Flopsstuff/keryx/firmware/README.md

# Firmware

ESP-IDF projects for the XIAO ESP32S3 on the reSpeaker Flex. The XVF3800 has to run the I2S firmware; see
[I2S mode](../docs/respeaker-flex-xvf3800.md#i2s-mode) in the board notes.

Flashing a release onto the board, with no ESP-IDF: [docs/flashing.md](../docs/flashing.md). Building, development
builds, console and releases: [docs/building.md](../docs/building.md).

## `xvf-bringup`

Checks that the ESP32, the XVF3800 and the codec work together:

1. scans I2C (expects 0x18 codec, 0x2C XVF3800) and reads the XVF3800 version and output routing;
2. measures BCLK, LRCLK and MCLK with the pins as inputs, and runs I2S as slave when the XVF3800 already drives
   them (it does with the I2S firmware), as master otherwise;
3. logs the level of both capture channels and the XVF3800 DoA twice a second, and plays a quiet 440 Hz beep
   (400 ms every 2 s, −24 dBFS) to the headphone jack. It holds the playback line low from the start and sends
   1.3 s of silence after I2S starts before the first beep; without that the first beep comes with noise.

## `mic-loopback`

Plays the XVF3800 capture straight back to the headphone jack from the ESP32, no host involved: processed beam in
the left ear, ASR beam in the right. 2 ms DMA blocks keep the ESP32's share of the delay at about 10 ms. Logs both
channel levels once a second.

## `usb-soundcard`

Prototype: the XIAO becomes a USB Audio Class device (`espressif/usb_device_uac` on TinyUSB), bridging the
XVF3800's I2S bus to the host.

- Microphone: 48 kHz, 16-bit stereo; left is the processed beam, right the ASR beam (the XVF3800's L/R outputs).
- At start-up it sets the XVF3800's ASR output gain (`AEC_ASROUTGAIN`, reset to 1.0 by the chip) to 4.0, +12 dB,
  over I2C with `components/xvf_control`. The ASR path has no AGC or limiter, so this fixed gain is its whole level
  control: speech at a distance now peaks around −15 dBFS instead of −27.
- Speaker: 48 kHz, 16-bit stereo, with the host's volume and mute applied in software, mixed to mono with everything
  else the board plays (see Volume below for how it reaches the codec and the XVF3800's echo reference).
- The start-up log is printed over the USB serial console; 4 s after boot TinyUSB takes the USB PHY, the console
  disappears and a composite device appears: the sound card (macOS lists it as "Keryx") and a CDC serial port
  (`/dev/cu.usbmodemkeryx_proto*` on macOS, `/dev/ttyACM*` on Linux, USB ID 303A:8000).
- That port is `components/keryx_console`: from then on the log goes there (while a host has the port open), and it
  takes commands, one per line: `bootloader` restarts into the ROM download mode on the serial/JTAG port, `reboot`
  restarts the firmware. `./flash.sh` uses `bootloader`, so no buttons are needed. Without it: press RESET while
  `./flash.sh` waits; holding BOOT on the XIAO while it powers up did not bring up the ROM download mode on our board.

## `wakeword`

The "Hey Keryx" wake word on the XIAO itself, from `components/keryx_wakeword`: the XVF3800's ASR channel goes
from 48 to 16 kHz with the filter the training audio went through (`scipy.signal.resample_poly`, run in esp-dsp's
decimating FIR, checked against plain C at start-up), into the
micro_speech frontend (`components/micro_frontend`, the TFLite Micro code pymicro-features wraps) and the model
from `wakeword/`, run streaming in float C: each 30 ms only the newest outputs of every layer are computed.

- A detection logs `>>> Hey Keryx! (score …)` and beeps on the headphone jack; the XVF3800 takes that line as its
  echo reference, so the beep does not reach the ASR channel.
- Once a second the log shows the highest score, the ASR peak level and the processing time per 10 ms of audio:
  about 0.86 ms (decimation 0.15, features 0.43, model 0.28), the model's weights kept in internal RAM.
- At start-up it sets `AEC_ASROUTGAIN` to 4.0, as `usb-soundcard` does: the model learned the channel at that gain.
- The model and threshold are `components/keryx_wakeword/kww_weights.h` and `include/kww_config.h`, written by
  `wakeword/export_model.py`.

The console stays on the USB serial port, so `idf.py monitor` (or `./flash.sh wakeword` and then any serial
terminal) shows the log. To record through the board again, flash `usb-soundcard`.

## `keryx`

The wake word and the USB sound card in one firmware; `wakeword` and `usb-soundcard` stay as their simpler
predecessors.

- One task reads I2S in 5 ms blocks and feeds both the wake word (ASR channel, as in `wakeword`) and the USB
  microphone (48 kHz, 16-bit stereo: processed beam, ASR beam) through a stream buffer. The XVF3800 clocks I2S and
  the host clocks USB, so audio older than 20 ms is dropped when the host reads.
- Playback: the host's packets go into a second buffer; a playback task writes I2S without a break, starting once
  30 ms are queued and dropping the excess beyond 80 ms. The sound card is asynchronous: its feedback endpoint asks
  the host for slightly more or fewer samples to keep ~40 ms queued, so the host follows the XVF3800's clock (the
  UAC component's own FIFO-count feedback lost ~0.4 % of the audio, see `components/usb_device_uac/KERYX.md`). A
  30 s sine plays without a single gap; the report shows the host's real rate.
- AEC: with clean playback the echo of speech from a speaker on the headphone jack reaches the ASR beam at the noise
  floor. The XVF3800's `AUDIO_MGR_SYS_DELAY` of −30 samples in this I2S build is right: 0, 12, 30 or 60 let the
  echo through.
- A detection prints `wake score=0.973` on the serial port (`components/keryx_console`, as in `usb-soundcard`) and
  plays a chime on the headphone jack, mixed into the host's playback. `sound thinking` loops a quiet "thinking"
  sound until `sound stop`, until the host's audio starts (above −54 dBFS) or for 60 s at most; `sound wake`
  plays the chime. The sounds are synthesised by `sounds/make_sounds.py` (`--export` writes the chosen ones to
  `keryx/main/keryx_sounds.h`; without it, candidates to listen to go to `sounds/candidates/`). The log goes to the same port, with a report every
  5 s: peak score, ASR level, processing time per 5 ms block (about 0.5 ms), USB microphone and speaker buffers.
- Serial port commands besides `bootloader` and `reboot`: `loop on` puts the XVF3800's echo reference — what was
  played — on the left capture channel instead of the processed beam, to measure the playback path; `loop mic`
  puts microphone 0 there, before AEC; `loop off` restores the beam. `xvf get|set <resid> <cmd> <int32|float|uint8>
  [count | values…]` reads or writes any XVF3800 parameter (e.g. `xvf get 33 3 int32`, AEC converged); `set` reads
  the value back, `xvf write …` does not, for write-only commands (the AEC filter's, see
  [the board notes](../docs/respeaker-flex-xvf3800.md#reading-the-aec-filter)). While
  `loop on` is set, the ASR beam lets echo through: it is for measuring only.
- Two I2C buses: the XVF3800's (D4/D5, also the codec) and one for our own STEMMA QT peripherals on D0 (SDA) / D3
  (SCL), I2C_NUM_1. They are kept apart because with the Adafruit rotary encoder (seesaw on a SAMD09) on the
  XVF3800's bus, the XVF3800 holds SCL for up to half a second after its address and stops answering — the ASR gain
  is then never set. `i2c scan` lists what answers on both, by bus (`xvf 0x2c XVF3800`, `periph 0x36 seesaw rotary
  encoder`; a held bus shows as `ESP_ERR_TIMEOUT`); `i2c read <addr> <n> [bytes…]` writes the bytes (a register),
  waits 5 ms and reads `n` bytes, `i2c write <addr> <bytes…>`, both on the peripherals' bus (e.g. `i2c read 0x36 4
  0x00 0x02`, a seesaw's product code and date), or with `xvf` on the XVF3800's (`i2c read xvf 0x18 1 82`, a codec
  register: there the read is one transaction with a repeated start, as the codec otherwise reads the next register).
- Pairing, through the same serial port (`components/keryx_net`): `set ssid|password|bridge|token <value>`,
  `config`, `erase`, `wifi scan`, `status`, `net check <host> <port>` (can the board open a TCP connection there:
  is the bridge reachable from this network?); answers end with an `ok` or `error` line. The settings live in NVS and
  survive flashing; the board joins Wi-Fi at start-up and after `set password`, retries with back-off (1 to 30 s),
  also when a connect fails at once (which sends no disconnect event), and reports `wifi associated ch=…`, `wifi
  connected ip=… rssi=…`, `wifi disconnected reason=…`, `wifi lost its address`. `status` also shows the XVF3800
  (`xvf=ok version=… i2s=running`, see Installing), the volume, the board's id (`keryx-` and the end of its MAC,
  also its USB serial number, so each board has its own port name), the firmware version (the last commit that
  touched `firmware/`, outside `release/`) and free memory. The XIAO needs its U.FL antenna: without it networks show at about −92 dBm.
- Memory: the wake word's weights and state take ~160 KB of internal RAM, and Wi-Fi needs its RX buffers there, so
  the 8 MB PSRAM is on for everything large, Wi-Fi, FreeRTOS and heap code stays in flash instead of IRAM, and Wi-Fi
  keeps 8 static RX buffers. About 33 KB of internal RAM stays free with Wi-Fi connected. The app builds for size
  except the wake word and its frontend (`-O2`); `partitions.csv` has two 3 MB app slots, for updates over Wi-Fi
  later, and 1.9 MB for a filesystem.
- What speech-to-text hears (`stt channel [l|r|a]`, kept in NVS, also over Wi-Fi): `l` (default) the processed beam,
  where the XVF3800's residual and non-linear echo suppression take Keryx's own voice out; `r` the ASR beam, as the wake
  word hears it, with no post-processing — inside the speaker Keryx's echo stays in it at about the user's level, and
  the beamformer turns to the speaker whenever the user pauses; `a` auto: L while the board plays and 1 s after (any
  output block above −54 dBFS), R otherwise, crossfading over 30 ms. L passes the XVF3800's AGC, so it is brought to R's
  level by ASR gain / AGC gain (`PP_AGCGAIN`, read every 0.5 s): the level does not jump between them. The wake word
  always runs on R. Both beams are decimated to 16 kHz, L's decimator in PSRAM. The firmware turns on `PP_NLATTENONOFF`
  (non-linear echo attenuation, off in Seeed's firmware) at start-up, as the XVF3800 forgets it at power-off; `status`
  shows `nl_atten=1`. Measured in the R1100 with the user silent while Keryx counted, then reading a sentence over it:
  Keryx's voice in L +6.1 dB over the room's noise without it, below the noise with it, at volume 54 and at 80, the
  first second included; the user's sentence over Keryx came through Whisper word for word either way, and R kept +7 to
  +11 dB of echo.
- The voice bridge (`components/keryx_link`): a WebSocket client to the `bridge` URL, connected all the time
  (ping every 10 s, reconnects every 2 s). Protocol v1 below. Wi-Fi power save (modem sleep, DTIM 3: pings take
  ~260 ms) goes off at a wake or a `play_start` (the bridge may speak first, with no wake) and back on 5 s after
  the stream and the playback have ended. The report adds a line for the link: state,
  frames up, bytes down, playback underruns.
- The watchdog (`main.c`): without the bridge for 3 min the board saves the end of its journal in NVS and restarts
  Wi-Fi (`keryx_net_restart`); after 10 min it saves it again and restarts, and if that brought no bridge either,
  restarts again every hour. Not while a USB host has the board (the bench, `converse.py`) or an update runs. With a
  saved journal the board's `hello` says `"saved_log":true`, and the bridge reads it (`log saved`) into its own log as
  `board saved log: …` lines, then clears it (`log saved clear`). A saved journal of an earlier run is kept until then,
  as that one saw the trouble begin. It began when a board stayed off Wi-Fi for eight hours, until it was powered off,
  with nothing left to say why.
- Volume: the board's own, 0–100 over everything it plays (the bridge's answers, its sounds, USB audio): 0 is silence,
  then 0.5 dB a step up to 0 dB at 100, kept in NVS (saved 2 s after the last change). It is the TLV320AIC3104 codec's
  analog volume in front of its output drivers (page 0, Table 10-51, soft-stepped by the codec): the DAC's hiss comes
  before it and goes down with the voice, where a software gain left it as loud at any volume. The XVF3800 takes its AEC
  reference from I2S channel 0 (L) only and sends both channels to the DACs, so the playback task puts different things
  in them: R is the mono mix at full scale, routed at the volume to the headphone jack (registers 50/64) and to the line
  output that feeds the amplifier on the SPEAKER connector (85); L is the same mix scaled in software by the codec's
  gain at that volume (Table 10-51's exact values), only the AEC reference, its routes to the outputs (47, 61, 82) off.
  The echo path from the reference to the microphones then does not change with the volume. With the volume after the
  reference it did, and the AEC, which follows a louder echo, never followed a quieter one: after the volume went down,
  Keryx's own voice stayed in the ASR beam at about −35 dBFS, at any lower volume and with the speaker muted, until the
  XVF3800 restarted; `AEC_FAR_EXTGAIN` (set to the volume, or its opposite) and rescaling the AEC filter by hand did not
  change that. Measured with the split, down from 66 or 90 to 40 the ASR beam carries Keryx at −54 to −58 dBFS, as a
  freshly converged AEC does. `AEC_FAR_EXTGAIN`, the gain between the reference and the loudspeaker, is therefore 0,
  written at start-up (the XVF3800 keeps it over a restart of the ESP32 alone); while the volume was a software gain,
  −23 dB at 54 made the residual echo suppression expect that much less echo, and Keryx's voice came through the
  processed beam at +20.6 dB over silence instead of +3.1 dB. Volume 0 also mutes the routes and the output drivers
  (registers 51/65/86, whose levels stay as the XVF3800 set them: +6 dB on the jack, 0 dB on the line; raising the
  line's only raised the hiss). The XVF3800 sets up the codec at boot (both DACs into every output), possibly after us,
  so the `xvf` task reads the registers back every 2 s and sets them again if they changed. `status` shows
  `far_extgain=…dB` and `codec=ok line=0x… line_from_l=0x… line_level=0x… reference=…dB` (registers 85, 82 and 86, and
  the reference's gain). At volume 90 the AEC cancels clearly less, in either scheme: probably the speaker is then
  louder than the microphones' gain allows for (see the board notes; not yet checked). `volume`, `volume <0-100>`,
  `volume up|down` (±10) on the console; `{"type":"volume",…}` from the bridge, see below. The macOS volume of the Keryx
  sound card still applies to USB audio on top, as a software gain.
- Microphone mute: while muted nothing captured leaves the board — the USB microphone and the bridge get silence,
  a running stream stops at once, the wake word does not run (and starts afresh, with its 2.5 s warm-up, when
  unmuted); playback is not affected. A short falling / rising two-note sound marks the change. Kept in NVS, saved
  0.2 s after a change. `mute`, `mute on|off` on the console (`wake` is refused while muted), `muted=0|1` in
  `status`; `{"type":"mute",…}` from the bridge, see below.
- `top [seconds]` on the console: how busy each core was and which tasks took the time. Idle, connected to Wi-Fi
  at 240 MHz: core 0 ~2 % (Wi-Fi, lwIP), core 1 ~12 % (the wake word 10 %, playback 2 %).
- More console commands: `wake` acts as if the wake word fired (to test the bridge without saying it), and
  `log <tag|*> <none|error|warn|info|debug>` changes a log level until the next restart (the WebSocket library's
  own log is off: it reports every failed attempt while the bridge is down).
- The journal (`components/keryx_console`): every line the console prints, except the 5 s report, also goes into 8 KB
  in PSRAM, each with the time it began (`HH:MM:SS` once SNTP has set the clock, `+<s since boot>s` before). `log
  recent` shows its last 2.7 KB, also over Wi-Fi; `log saved` the end the watchdog saved in NVS, `log saved clear`
  forgets it.
- Tasks: core 1 has capture (wake word, priority 6), playback (7) and the panel (3); core 0 USB, Wi-Fi, lwIP, the
  WebSocket client and the console. USB audio runs at priority 20, above lwIP (18): at 5 it starved during Wi-Fi
  traffic and dropped audio. The panel was on core 0 too, until an answer's audio, which the bridge sends faster than
  real time (10 s of it in about a second), kept Wi-Fi, lwIP and the WebSocket client busy long enough to stop the
  ring for over a second as Keryx began to speak. `status` counts the frames that came 150 ms or more late
  (`stalls=… longest=… ms`), and each one is logged with the panel's state.
- The panel (`components/keryx_panel`), on the peripherals' I2C bus: an Adafruit I2C QT Rotary Encoder (seesaw, 0x36)
  and an Adafruit NeoDriver (seesaw, 0x60) driving a ring of 24 WS2812. Turning the knob changes the volume, 2 steps (1
  dB) a detent, clockwise louder; a short press ends a running conversation (`{"type":"stop"}` to the bridge) and
  otherwise acts as the wake word; holding it for 1 s mutes or unmutes the microphone. The ring: a clock when idle
  (marks at 12, 3, 6 and 9, amber by day and yellow at night, the minute hand one blue pixel, the hour hand the two
  green pixels nearest its angle; the hands cover the marks, the minute hand the hour hand), the same clock with red
  marks when muted, a level meter while listening (the whole conversation) and while answering, a purple comet while
  waiting for the answer (the thinking sound), one orange pixel breathing without a bridge, and for 1.5 s after any
  volume change an arc as long as the volume. The meter: the pixels at 3 and 9 o'clock stay at half brightness, and arcs
  grow from them both ways, to meet at 12 and 6 at full level (quick up, slow down; brightest at the roots, over a faint
  glow of the rest). Listening it follows the ASR beam's peak, −45 to −12 dBFS, in blue (hue 220°), the glow breathing;
  answering it follows what is played before the volume (the answers, the board's sounds, USB audio), −40 to −8 dBFS, in
  turquoise (160°). `ring hue [<listening> <speaking>]` sets the two hues (0–359). Everything is drawn clockwise from 12
  o'clock: `ring top <0-23>` names the pixel at 12 and `ring reverse` flips the direction, as the ring is mounted. The
  brightness is at most a percentage of full, by day and by night: `ring brightness` shows it, `ring brightness
  day|night <1-100> [HH:MM]` sets a level and when it begins (default 20 % from 07:00, 5 % from 22:00). These settings
  live in NVS. The time comes over SNTP (`pool.ntp.org`), Europe/Warsaw (`CLOCK_TZ` in `main.c`); until then there is no
  clock and it is day. 30 frames a second; only frames that changed go out. Each module is looked for every 2 s until it
  answers, and again after an I2C error, so either can be missing or plugged in later. `status` adds `panel encoder=ok
  ring=ok i2c_errors=0`.
- The console over Wi-Fi: the bridge sends `{"type":"console","id":…,"line":…}`, the console task runs the line as if
  typed and sends back what it printed (`keryx_console_submit`, up to 3 KB). Only a safe set runs this way
  (`REMOTE_COMMANDS` in `main.c`: `status`, `config`, `volume`, `mute`, `wake`, `sound`, `ring`, `top`, `log`, `xvf
  get`, `i2c scan`, `i2c read`, `net check`, `ota`); `set`, `erase`, `wifi scan`, `bootloader`, `reboot`, `loop`, `xvf
  set` and `i2c write` need the serial port. On the bridge host: `./console.sh ring brightness`.
- Updates over Wi-Fi (`components/keryx_ota`): `ota`, `ota check`, `ota update [force]` (the latest GitHub release),
  `ota url <url>` (any image); a new image is on trial for 30 s and the bootloader rolls back one that restarts sooner.
  See [docs/building.md](../docs/building.md#updates-over-wi-fi).

### Bridge protocol v1

The board connects to `ws://…` (the `bridge` setting) and keeps the connection. Text frames are JSON; binary frames
are PCM16 little-endian mono.

| Direction | Message | Meaning |
|---|---|---|
| board → bridge | `{"type":"hello","id":…,"token":…,"firmware":…,"volume":…,"muted":…}` | first message; a wrong token: close with 4001. With `"saved_log":true` the board saved its journal while it had no bridge: the bridge reads it with the console line `log saved`, then `log saved clear` |
| bridge → board | `{"type":"ready"}` | accepted |
| board → bridge | `{"type":"wake","score":0.97,"preroll_ms":500}` | the wake word fired; audio follows |
| board → bridge | binary, 16 kHz, 20 ms (640 bytes) | the ASR beam: `preroll_ms` from before the wake, then live, until `listen_stop`. A wake during a stream sends `preroll_ms: 0` and the stream goes on unbroken |
| bridge → board | `{"type":"listen_stop"}` | stop streaming (the board stops by itself after 2 min) |
| bridge → board | `{"type":"sound","name":"wake"\|"thinking"\|"stop"}` | the board's own sounds |
| bridge → board | `{"type":"play_start","rate":24000}`, binary, `{"type":"play_end"}` | an answer, 24 or 16 kHz, any frame size, faster than real time is fine: the board buffers 10 s (holding back TCP beyond that), starts once 150 ms are queued and upsamples to 48 kHz |
| bridge → board | `{"type":"play_stop"}` | cut the answer now (10 ms fade) |
| board → bridge | `{"type":"played"}` | the answer has really finished playing, or was cut |
| bridge → board | `{"type":"volume","value":60}`, `{"type":"volume","delta":-10}`, `{"type":"volume"}` | set the volume, change it, or ask for it |
| board → bridge | `{"type":"volume","value":60}` | the volume, after every change whoever made it (bridge, console, the knob) |
| bridge → board | `{"type":"mute","value":true}`, `{"type":"mute"}` | mute or unmute the microphone, or ask whether it is muted |
| board → bridge | `{"type":"mute","value":true}` | the mute state, after every change whoever made it, and when asked; muting also ends a running stream at once |
| board → bridge | `{"type":"stop"}` | the stop button: end the conversation — the bridge stops the answer (`play_stop`) and the stream (`listen_stop`) |
| bridge → board | `{"type":"console","id":7,"line":"ring brightness"}` | run a console line, if it is in the safe set |
| board → bridge | `{"type":"console","id":7,"output":"ok ring brightness …\n"}` | what it printed (`error not allowed over Wi-Fi …` otherwise) |

Measured against a test server, through the echo reference (`loop on`): 24 and 16 kHz answers clean (residual
−40 dB), `played` 3.06 s after the first byte of a 3 s answer, 90–170 ms after `play_stop`; uplink frames 18 ms
apart on average, at most ~40 ms.
- The host should send 48 kHz: macOS converting 16 kHz on the fly (PortAudio with its default small blocks) breaks
  up the sound on this device; 24 and 44.1 kHz were fine.
