Flopsstuff/keryx/docs/respeaker-flex-xvf3800.md

# reSpeaker Flex XVF3800 Circular-4

The microphone array Keryx listens through: a Seeed Studio carrier board built around the XMOS XVF3800 voice
processor, with a 4-mic circular daughter board attached over FPC.

## Official documentation

Seeed Studio:

- [reSpeaker Flex wiki](https://wiki.seeedstudio.com/respeaker_flex_introduction/) — hardware, firmware
  variants, flashing, safe mode.
- [reSpeaker Flex repository](https://github.com/respeaker/reSpeaker_Flex) — firmware images
  (`xmos_firmwares/usb`, `xmos_firmwares/i2s`) and the Python control tool (`python_control/xvf_host.py`).
- [Product page, Circular-4](https://www.seeedstudio.com/reSpeaker-Flex-XVF3800-Circular-4-p-6737.html).
- [reSpeaker XVF3800 USB Mic Array wiki](https://wiki.seeedstudio.com/respeaker_xvf3800_introduction/) — the
  non-Flex sibling on the same chip; useful for overlapping topics.
- [reSpeaker XVF3800 USB 4-mic array repository](https://github.com/respeaker/reSpeaker_XVF3800_USB_4MIC_ARRAY)
  — native `xvf_host` binaries (including `mac_arm64`) and its
  [host control README](https://github.com/respeaker/reSpeaker_XVF3800_USB_4MIC_ARRAY/blob/master/host_control/README.md).

XMOS (the chip itself, firmware v3.2.1):

- [XVF3800 product page](https://www.xmos.com/xvf3800).
- [User Guide (HTML)](https://www.xmos.com/documentation/XM-014888-PC/html/doc/user_guide/index.html) /
  [PDF](https://www.xmos.com/documentation/XM-014888-PC/pdf/xvf3800_user_guide_v3.2.1.pdf) — control commands,
  output selection (section 3.6.1), tuning.
- [Using the host application](https://www.xmos.com/documentation/XM-014888-PC/html/modules/fwk_xvf/doc/user_guide/03_using_the_host_application.html).
- [Tuning the application](https://www.xmos.com/documentation/XM-014888-PC/html/modules/fwk_xvf/doc/user_guide/04_tuning_the_application.html).
- [Programming Guide (PDF)](https://www.xmos.com/documentation/XM-014888-PC/pdf/xvf3800_programming_guide_v3.2.1.pdf).

## Hardware

- 4 PDM MEMS microphones in a circle, 44 mm between neighbours, 360° pickup.
- XMOS XVF3800 does all DSP on-board: AEC, beamforming, DoA, AGC, VAD, noise suppression, de-reverberation.
- TLV320AIC3104 codec; 3.5 mm AUX out and a JST speaker connector driven by an amplifier (up to 10 W into 4 Ω,
  needs the 12 V terminal).
- USB-C (UAC 2.0 and DFU), 2 GPIO lines on the FPC, RST and Boot (safe mode) buttons.
- Footprint for an optional XIAO ESP32S3 connected over I2S + I2C; that setup needs the I2S firmware instead of
  the USB one.
- The green PWR LED sits on the power rail; no firmware can switch it off.

Core board, back and front

Images in this document come from the [Seeed wiki](https://wiki.seeedstudio.com/respeaker_flex_introduction/).

## Pins

Pin headers

### XVF3800 header (2×10)

Pin 1 is the square pad; 1–10 run down the outer column, 20–11 down the inner one.

XVF3800 header schematic

| Pin | Signal | Pin | Signal |
|---|---|---|---|
| 1 | X1D11 — I2S MCLK | 20 | X1D10 — I2S BCLK |
| 2 | X1D01 — I2S LRCK | 19 | X1D22 — I2S DATA1 (processed audio to the host) |
| 3 | X1D00 — I2S DATA0 (reference in from the host; out in USB builds) | 18 | X1D34 — I2S DATA2 |
| 4 | GND | 17 | GND |
| 5 | X0D38 — I2C SDA, 4.7 kΩ pull-up to VDDIO | 16 | X0D00 — SPI CS_N |
| 6 | X0D37 — I2C SCL, 4.7 kΩ pull-up to VDDIO | 15 | X0D10 — SPI CLK |
| 7 | X1D13 — button input (active low) | 14 | X0D11 — SPI MOSI |
| 8 | GND | 13 | X0D39 — SPI MISO |
| 9 | 5V_IN | 12 | GND |
| 10 | 5V_IN | 11 | VDDIO (3.3 V) |

The front silkscreen photo says X0D13 on pin 7; the schematic and the back silkscreen say X1D13.

### XIAO ESP32S3

XIAO schematic

The GPIO numbers printed inside the XIAO symbol above belong to a different XIAO; the ESP32-S3 numbers below come
from the XIAO ESP32S3 pinout.

| XIAO | ESP32-S3 | Used for |
|---|---|---|
| D0 | GPIO1 (ADC1, touch) | on the 4-pin header; SDA of our peripherals' I2C bus |
| D1 | GPIO2 | not on the header; most likely the XVF3800 reset line |
| D2 | GPIO3 (ADC1, touch, strapping pin) | free, on the 4-pin header |
| D3 | GPIO4 (ADC1, touch) | on the 4-pin header; SCL of our peripherals' I2C bus |
| D4 | GPIO5 | I2C SDA |
| D5 | GPIO6 | I2C SCL |
| D6 | GPIO43 | I2S DATA1, audio from the XVF3800 |
| D7 | GPIO44 | I2S DATA0, audio to the XVF3800 |
| D8 | GPIO7 | I2S LRCK |
| D9 | GPIO8 | I2S BCLK |
| D10 | GPIO9 | I2S MCLK |

The 4-pin header next to the XIAO carries GND, D3, D2 and D0; it has no 3.3 V pin.

### What is free for our own peripherals

- **ESP32 D2** (and D0, D3, which `keryx` uses for its peripherals' I2C bus) — any function through the GPIO matrix:
  buttons, an encoder (PCNT), WS2812 data (RMT). All three are ADC1 channels (GPIO1–10 are), so a resistor ladder can
  put several buttons on one pin; ADC1 keeps working while Wi-Fi is on. D2 (GPIO3) is a strapping pin: fine as a GPIO,
  but nothing should hold it at a fixed level during boot.
- **XVF3800 X0D11 and X0D39** — outputs driven with `GPO_WRITE_VALUE`, e.g. plain LEDs through a ~1 kΩ
  resistor. SPI control is not used by the USB or I2C builds. X0D00 and X0D10 cannot be driven from the Seeed
  firmware.
- **XVF3800 X1D13** — a button input; what the Seeed firmware does with it is unknown, and the Seeed
  `xvf_host.py` has no command to read it.
- **The shared I2C bus** (header pins 5 and 6, the same lines as XIAO D4/D5) — in principle room for I2C expanders,
  encoders or LED drivers, but the XVF3800 is a fussy slave here: with an Adafruit seesaw rotary encoder (SAMD09) on
  this bus it holds SCL after its address and stops answering, while a seesaw NeoDriver (ATtiny) was fine. The `keryx`
  firmware therefore puts its peripherals on a second bus on D0/D3, powered from VDDIO (pin 11). Taken addresses: 0x2C
  (XVF3800) and 0x18 (the TLV320AIC3104 codec). The XMOS pinout also lists this bus as the way the XVF3800 controls the
  DAC, so in the USB builds it probably acts as a master here; adding a second master needs care.
- **Power**: 5V_IN (pins 9, 10), VDDIO 3.3 V (pin 11), GND.

## Our unit

Since 2026-09-30 the board runs the I2S firmware `respeaker_flex_i2s_c48k2ch_v1.0.4.bin` and talks to the XIAO
ESP32S3 only; see [I2S mode](#i2s-mode). The readings below were taken over USB with the 6-channel USB firmware
on 2026-09-28:

| Property | Value |
|---|---|
| USB name | `reSpeaker Flex XVF3800 C16K6Ch` |
| VID / PID | `0x2886` / `0x001e` |
| Firmware | `VERSION` 1.0.3, `BLD_MSG` `ua-io16-6ch-sqr` (image `respeaker_flex_usb_c16k6ch_v1.0.3.bin`) |
| Audio | 6 channels in, 2 channels out, 16 kHz, 16-bit |
| `AEC_MIC_ARRAY_TYPE` | 2 (squarecular) |
| `AUDIO_MGR_MIC_GAIN` | 10.0 |
| `AUDIO_MGR_SYS_DELAY` | 12 samples |

Microphone positions from `AEC_MIC_ARRAY_GEO`, in metres:

| Mic | X | Y |
|---|---|---|
| 0 | 0.022 | -0.022 |
| 1 | 0.022 | 0.022 |
| 2 | -0.022 | 0.022 |
| 3 | -0.022 | -0.022 |

## Input channels of the 6-channel firmware

Each USB input channel is fed by an output mux configured as a `(category, source)` pair. The values below were
read from the device; the meaning comes from Table 3.2 of the XMOS User Guide.

| USB channel (0-based) | Command | Value | Signal |
|---|---|---|---|
| 0 | `AUDIO_MGR_OP_L` | 8, 0 | User chosen channel — currently a copy of the auto-select processed beam |
| 1 | `AUDIO_MGR_OP_R` | 7, 3 | ASR output of the auto-select beam |
| 2 | `AUDIO_MGR_OP_CH3` | 1, 0 | Raw mic 0, before amplification |
| 3 | `AUDIO_MGR_OP_CH4` | 1, 1 | Raw mic 1, before amplification |
| 4 | `AUDIO_MGR_OP_CH5` | 1, 2 | Raw mic 2, before amplification |
| 5 | `AUDIO_MGR_OP_CH6` | 1, 3 | Raw mic 3, before amplification |

Mux categories (XMOS User Guide, Table 3.2):

| Category | Signal | Sources |
|---|---|---|
| 0 | Silence | 0 |
| 1 | Raw microphone data, before amplification | 0–3: mic index |
| 2 | Unpacked microphone data | 0–3 (packed input only) |
| 3 | Amplified microphone data with system delay | 0–3: what the SHF cores receive |
| 4 | Far end (reference) | 0 |
| 5 | Far end (reference) with system delay | 0 |
| 6 | Processed data | 0, 1: slow-moving beams; 2: fast-moving beam; 3: auto-select beam |
| 7 | AEC residual / ASR data | 0–3: per mic residual or per beam ASR output |
| 8 | User chosen channels | 0, 1: copy of the auto-select beam by default |
| 9 | Post SHF DSP channels | 0–3 |
| 10 | Far end at native rate | 0–5 |
| 11 | Amplified microphone data before system delay | 0–3 |
| 12 | Amplified far end with system delay | 0 |

## I2S mode

Measured by `firmware/xvf-bringup` on the XIAO ESP32S3 with `respeaker_flex_i2s_c48k2ch_v1.0.4.bin`:

| Property | Value |
|---|---|
| I2C devices | 0x18 (TLV320AIC3104 codec), 0x2C (XVF3800) |
| `VERSION` | 1.0.4 |
| I2S clocks | **driven by the XVF3800**: BCLK 3.072 MHz, LRCLK 48 kHz, MCLK 24.576 MHz |
| I2S format | Philips, 32-bit slots, stereo; the ESP32 must run as I2S **slave** |
| Capture channels | L = `8,0` processed auto-select beam, R = `7,3` ASR auto-select beam |
| `AUDIO_MGR_OP_UPSAMPLE` / `AUDIO_MGR_OP_PACKED` | 1,1 / 0,0 |
| Playback | ESP32 → I2S DATA0 → codec → headphone jack works |
| Codec set-up by the XVF3800 | jack: DACs at 0 dB, drivers +6 dB; line out (LEFT_LOP/M): both DACs at −12 dB, 0 dB |
| Codec noise | the DAC hisses before its analog output volume: the hiss follows registers 82/85 and 86 |
| AEC reference | I2S channel 0 (L) only; both channels go to the DACs |
| `REBOOT` (48, 7) | restarts the XVF3800 in about 0.5 s, I2S included; parameters back to their defaults |
| Not answering over I2C | `BLD_MSG` (status 66), `AIC3104_HP_LEVEL` (status 97) |

The Seeed firmware README calls the I2S images "I2S slave" and the Seeed I2S test sketch runs the ESP32 as master,
but the bus is already clocked by the XVF3800 as soon as it boots; an ESP32 driving BCLK/LRCLK as well would fight
it.

Playback start-up: sound sent within the first moments after the ESP32 starts I2S comes out of the headphone jack
with noise. Sending silence for about a second first, and holding the ESP32's playback data pin (GPIO44) low from
the start of `app_main` until I2S takes it over, gives a clean first sound. Before `app_main` runs, during the ESP32
boot, that line still floats; a 10–100 kΩ pull-down on it would cover that window in hardware.

The I2C control protocol: write `{resid, cmd | 0x80, length + 1}`, then read `length + 1` bytes, the first being
a status (0 = OK, 64 = retry). Parameter ids are the same as over USB (see `xvf_host.py`).

### The AEC and the volume

Measured in the R1100 (its knob at half), with Keryx counting and nobody talking:

- The reference is I2S channel 0 only: noise in R alone comes out of the speaker and the microphones hear it, while
  the reference stays digital zero.
- The AEC follows a louder echo, not a quieter one. With a gain between the reference and the speaker turned down
  (the codec's volume, or the microphones' gain), the old echo stays subtracted: Keryx's voice stays in the ASR beam
  at about −35 dBFS, at any lower volume and even with the speaker muted, until the XVF3800 restarts or the gain
  comes back up. `AEC_FAR_EXTGAIN` does not change that, nor does path change detection (`AEC_PCD_COUPLINGI`, off
  by default), which only suppresses the processed beam harder, the user's voice included. `keryx` therefore keeps
  that gain constant: the volume is applied to the reference as well.
- Gain structure: at volume 100 the microphones after gain are 11–15 dB below the reference (XMOS asks for at least
  6 dB). The AEC filter's frequency-domain peak is −8.4 dB at volume 66, so above 0 dB near full volume, where XMOS
  says to lower `AUDIO_MGR_MIC_GAIN`; at volume 90 the AEC cancels clearly less.

### Reading the AEC filter

The AEC filter (3072 taps per microphone, `SPECIAL_CMD_AEC_FILTER_LENGTH` 33/93) can be read and written over I2C with
the special commands, in the order of XMOS' `host_xvf_control` (`src/special_commands/filters.cpp`):

1. `SHF_BYPASS` (33/70) = 1, so that the filter does not adapt meanwhile;
2. `SPECIAL_CMD_AEC_FAR_MIC_INDEX` (33/90) = far, mic — write-only: it must not be read back (`xvf write`, not
   `xvf set`). Read back, or sent without the bypass, it left the XVF3800's control dead until a power cycle;
3. for each chunk: `SPECIAL_CMD_AEC_FILTER_COEFF_START_OFFSET` (33/91) = offset, then read or write
   `SPECIAL_CMD_AEC_FILTER_COEFFS` (33/92), 15 floats — always 15, the last chunk padded;
4. `SHF_BYPASS` = 0.

Reads of one microphone after another work; a read after a write fails (status error) until
`AEC_FILTER_CMD_ABORT` (33/94) is written. Over the console a microphone takes about 22 s. Rescaling the filter
to a new volume gave the same filter as a fresh convergence at that volume, yet the echo stayed: the AEC keeps state
these commands do not reach.

### Switching firmware

- **USB → I2S:** with the USB firmware running, connect the Flex USB-C port (next to RST) and run
  `dfu-util -R -e -a 1 -D respeaker_flex_i2s_c48k2ch_v1.0.4.bin`. Afterwards the board disappears from USB.
- **I2S → USB:** power the board off, hold Boot, power it on (safe mode, USB DFU available), then flash a USB
  image the same way.
- Alt 1 is the upgrade partition; alt 0 holds the factory safe-mode image and is left alone.

## Control from macOS

`xvf_host.py` talks to the chip over USB control transfers and needs `pyusb` plus `libusb`
(`brew install libusb`). Without `--pid` it finds the device by the Seeed VID alone.

```bash
python xvf_host.py VERSION
python xvf_host.py --list              # every command with its description
python xvf_host.py DOA_VALUE           # angle 0..359 and a speech flag
python xvf_host.py AEC_AZIMUTH_VALUES  # radians: beam 1, beam 2, free-running, auto-select
python xvf_host.py AUDIO_MGR_OP_L 1 0  # route raw mic 0 to channel 0
python xvf_host.py SAVE_CONFIGURATION 1
```

Changes are lost on reboot unless saved with `SAVE_CONFIGURATION`; `CLEAR_CONFIGURATION` returns to defaults.
