Flopsstuff/keryx/(list of files, cad)

Other CAD files:
cad/bottle_cap.stl
cad/mic_hat.stl
cad/encoder_knob.stl
