Flopsstuff/keryx/firmware/components/xvf_control/include/xvf_control.h

/*
 * XVF3800 control over I2C: the same resource/command parameters as the USB control protocol (tools/xvf), see
 * docs/respeaker-flex-xvf3800.md for their meaning.
 */
#pragma once

#include <stddef.h>
#include <stdint.h>

#include "driver/gpio.h"
#include "driver/i2c_master.h"
#include "esp_err.h"

#define XVF_I2C_ADDR 0x2C

// AEC_ASROUTGAIN: fixed gain on the ASR output (float, linear, 0..1000, 1.0 after reset)
#define XVF_AEC_RESID 33
#define XVF_AEC_ASROUTGAIN 36
// AEC_FAR_EXTGAIN: gain in dB between the AEC reference and the loudspeaker (float, 0 by default): the volume, as
// it is the codec's, after the reference
#define XVF_AEC_FAR_EXTGAIN 5

// PP_AGCGAIN: the AGC's current gain on the processed beam (float, linear)
#define XVF_PP_RESID 17
#define XVF_PP_AGCGAIN 13
// PP_NLATTENONOFF: non-linear echo attenuation on the processed beam (int32, 0 off, 1 on; off in Seeed's firmware)
#define XVF_PP_NLATTENONOFF 27

esp_err_t xvf_control_init(gpio_num_t sda, gpio_num_t scl);

// The board's I2C bus (also the codec and our own peripherals), valid after xvf_control_init.
i2c_master_bus_handle_t xvf_i2c_bus(void);

// Write {resid, cmd | 0x80, length + 1}, then read back a status byte followed by the payload.
esp_err_t xvf_read(uint8_t resid, uint8_t cmd, void *out, size_t len);

// Write {resid, cmd, length, payload}. The chip does not acknowledge writes; read the value back to check.
esp_err_t xvf_write(uint8_t resid, uint8_t cmd, const void *data, size_t len);

// The TLV320AIC3104 codec on the same bus, which the XVF3800 sets up at boot (page 0 registers).
#define CODEC_I2C_ADDR 0x18
esp_err_t codec_read(uint8_t reg, uint8_t *value);
esp_err_t codec_write(uint8_t reg, uint8_t value);

// Writes a float parameter and reads it back; ESP_ERR_INVALID_RESPONSE if the chip reports something else.
esp_err_t xvf_set_float(uint8_t resid, uint8_t cmd, float value);

// Sets a float parameter from a background task, retrying until the chip reads it back: after power-up the
// XVF3800 boots more slowly than the ESP32 and does not answer at first. `name` is only for the log.
void xvf_set_float_when_ready(uint8_t resid, uint8_t cmd, float value, const char *name);
