Flopsstuff/keryx/(commit log)

2026-09-28 🎉 Start Keryx: README, .gitignore and .gitattributes
2026-09-28 ✨ Add XVF3800 control client and live dashboard
    tools/xvf reads and writes the chip's parameters over USB control
    transfers. tools/dashboard captures all six channels, polls the
    beamformer state and streams both to a browser page: beam directions
    and speech energy, a host-side SRP-PHAT scan over the raw mics, level
    meters, waveforms and spectrograms. The dial can be flipped and rotated
    to match how the board lies, and channels 2-5 can be re-routed between
    raw and amplified mic signals.
    [control.py]
2026-09-28 📝 Document reSpeaker Flex pin headers and free pins
    Adds the XVF3800 2x10 header and XIAO ESP32S3 pin maps from the Seeed
    wiki (board photos and header schematics under docs/images, stored in
    LFS), and lists what is free for our own peripherals: ESP32 D0/D2/D3,
    XVF3800 outputs X0D11/X0D39, the X1D13 button input and the shared I2C
    bus.
2026-09-30 ✨ Add XVF3800 I2S bring-up firmware for the XIAO ESP32S3
    firmware/xvf-bringup (ESP-IDF v5.5.5) checks the XIAO, XVF3800 and
    codec together: I2C scan and XVF3800 control reads, detection of who
    drives the I2S clocks, full-duplex I2S with level and DoA logging, and
    a beep to the headphone jack.
    The board notes gain an I2S mode section: with the Seeed I2S firmware
    the XVF3800 is the I2S clock master (48 kHz, 32-bit), so the ESP32 runs
    as slave; the I2C control protocol; how to switch between USB and I2S
    firmware; and how to get a clean first sound after I2S starts.
2026-09-30 ✨ Add USB sound card prototype on the XIAO ESP32S3
    firmware/usb-soundcard bridges the XVF3800's I2S bus to a USB Audio
    Class device: 48 kHz 16-bit stereo microphone (processed and ASR beams)
    and speaker to the headphone jack, with host volume and mute. macOS
    lists it as "Keryx".
    espressif/usb_device_uac 1.3.1 is vendored under firmware/components
    with one patch: the audio control interface string, which macOS shows
    as the device name, comes from CONFIG_UAC_TUSB_PRODUCT instead of the
    hard-coded "usb uac". firmware/flash.sh flashes within the few seconds
    the serial console exists after boot, since the XIAO's BOOT button did
    not bring up download mode here.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
2026-09-30 ✨ Add ESP32 microphone loopback firmware
    firmware/mic-loopback plays the XVF3800 capture straight back to the
    headphone jack from the ESP32, processed beam left and ASR beam right,
    with 2 ms DMA blocks for about 10 ms of delay on the ESP32 side.
2026-09-30 🔇 Silence ESP-IDF activation output in flash.sh
    export.sh reports its checks on stderr, which cluttered the script's
    output.
2026-10-03 ✨ Train the «Hey Keryx» wake word and run it on the ESP32
    The XIAO now recognises «Хей / Эй, Керикс» and "Hey, Keryx" by itself
    (6 of 6 live phrases on the first try) and beeps on the headphone jack.
    Firmware:
    - wakeword: the XVF3800's ASR channel goes to 16 kHz with the filter the
    training audio went through, into the micro_speech frontend and the model,
    streaming in float C; detections are logged and beeped.
    - components/keryx_wakeword: decimation, frontend wrapper, streaming model
    and its weights; components/micro_frontend: the TFLite Micro frontend and
    KISS FFT as pymicro-features builds them, vendored unchanged.
    - components/xvf_control: I2C control of the XVF3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
2026-10-03 ⚡️ Keep the wake word weights in RAM
    As const data the ~120 KB of weights stayed in flash behind the 32 KB data
    cache and streamed through it on every inference. In internal RAM the
    chain takes 1.1 ms per 10 ms of audio instead of 3.5 ms (decimation 0.41,
    features 0.44, model 0.29), which the firmware now logs separately.
2026-10-03 ⚡️ Decimate with esp-dsp's FIR
    The 48 -> 16 kHz filter runs in esp-dsp's decimating FIR, the ESP32-S3 SIMD
    build: 0.15 ms per 10 ms of audio instead of 0.41, 0.86 ms for the whole
    chain. esp-dsp needs 16-byte aligned buffers, so the filter falls back to the
    plain C version if it refuses them, and a start-up self-check compares the
    two (they differ by one 16-bit step at most).
2026-10-04 ✨ Add a serial console port next to the USB sound card
    usb-soundcard is now a composite device: the UAC sound card plus a CDC
    serial port (keryx_console) that carries the log and takes commands.
    `bootloader` restarts into the ROM download mode, which flash.sh uses,
    so flashing needs no buttons.
2026-10-04 ✨ Combine the wake word and the USB sound card in one firmware
    firmware/keryx reads I2S once and feeds the wake word and the USB
    microphone from it; detections go to the host as `wake score=…` on the
    serial console. Playback goes through its own buffer and a task that
    writes I2S without a break, which removes the gaps of writing each 1 ms
    USB packet straight to I2S. `loop on` routes the XVF3800's echo
    reference to the left capture channel to measure the playback path.
    tools/listen.py records the board around every wake event.
2026-10-04 🔊 Replace the wake beep with synthesised chime and thinking sounds
    firmware/sounds/make_sounds.py synthesises candidate interface sounds and
    exports the chosen ones (a rising glass ping for the wake word, soft
    falling taps for thinking) into keryx_sounds.h. The thinking loop runs on
    `sound thinking` until `sound stop`, the host's audio or 60 s.
    [main.c]
2026-10-04 ✨ Talk to Hermes through the board with converse.py
    tools/converse.py lets the Mac stand in for the voice bridge: the board's
    wake word opens one xAI streaming speech-to-text session (Smart Turn) for
    the whole conversation, each utterance goes to Hermes'
    /v1/chat/completions, and every finished sentence of the streamed reply
    goes to xAI text-to-speech and plays through the board, so the XVF3800
    cancels it as echo. Follow-up requests need no wake word; talking over an
    answer stops it; words heard while the speaker played that Keryx itself
    said are dropped as echo. The board's mic and speaker share one duplex
    stream, since CoreAudio refuses a second one on the same device, and the
    board play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
2026-10-04 ✨ Pair the board over the USB console and join Wi-Fi
    components/keryx_net keeps Wi-Fi and voice bridge settings in NVS, set
    through new console commands (set, config, erase, wifi scan, status,
    net check), joins Wi-Fi at start-up and reconnects with back-off. Each
    board gets a USB serial number from its MAC.
    To make room for Wi-Fi, PSRAM is on, Wi-Fi/FreeRTOS/heap code moves from
    IRAM to flash and Wi-Fi keeps 8 static RX buffers; the app builds for
    size except the wake word. A custom partition table has two 3 MB app
    slots and a filesystem.
    [partitions.csv]
2026-10-04 💬 Rewrite the voice prompt in English with a device status section
    The prompt now says what Keryx is, how to answer for speech (short,
    plain spoken text, a quick first sentence, Russian by default), and that
    a "Device status" section follows for the bridge to fill with the
    speaker's state.
2026-10-04 ✨ Add bridge.py: the voice bridge for the board on Wi-Fi
    The pipeline of converse.py moves to tools/voice.py and works through
    three adapters: a microphone, a speaker and the board's sound commands.
    converse.py keeps the USB ones (sound card, serial console); bridge.py
    adds a WebSocket server on :8765/keryx speaking protocol v1 agreed with
    the firmware: hello with a token (KERYX_BRIDGE_TOKEN in .env), wake plus
    16 kHz microphone frames up, play_start / PCM / play_end, play_stop,
    sound and listen_stop down, played when the board has finished. Tested
    with a fake board client; --echo answers without Hermes.
2026-10-04 ✨ Talk to the voice bridge over a WebSocket
    components/keryx_link keeps a WebSocket to the bridge and speaks protocol
    v1 (firmware/README.md): after a wake it streams the 16 kHz ASR beam with
    500 ms of preroll until listen_stop, plays the bridge's 24 or 16 kHz
    answers through a 10 s buffer and an upsampler, cuts them on play_stop
    and reports played. Wi-Fi power save is off during a conversation.
    Internal RAM ran out with the client: its buffers and the link task's
    stack go to PSRAM. USB audio tasks run at priority 20, above lwIP, which
    is pinned to core 0: Wi-Fi traffic starved them. New console commands:
    wake, to test without saying it, and log, to change log levels.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
2026-10-04 🐛 Stop the USB speaker from losing audio, and steer the host's rate
    The UAC component read exactly 1 ms per packet into a single buffer: a
    packet the speaker task had not taken was overwritten (~0.4 % of the
    audio lost, clicks the AEC could not cancel). The task now takes all
    the FIFO holds, and the feedback endpoint follows the fill of our own
    playback buffer instead of the FIFO count, so the host follows the
    XVF3800's clock: a 30 s sine plays without a gap.
    Console: xvf get|set for any XVF3800 parameter, loop mic for the echo
    before AEC.
2026-10-04 🔊 Give the board a volume the bridge and the console can set
    One volume, 0-100, over everything the board plays: the bridge's
    answers, its own sounds and USB audio. It is kept in NVS, set with
    `volume` on the console and with {"type":"volume"} from the bridge,
    and reported back to the bridge after every change and in hello, so
    Hermes can read and change it.
    Console: `top` shows how busy each core and task is.
2026-10-04 🔧 Version the firmware by firmware/ alone
    ESP-IDF's version marks the build dirty for any uncommitted change in
    the repository, host tools included. Take the last commit that touched
    firmware/ instead, and "-dirty" only for changes under it.
2026-10-04 📦 Make the voice bridge an installable package with a service
    tools/voice.py and tools/bridge.py move to bridge/keryx_bridge/ and the
    voice prompt into the package, so the bridge installs on its own from a
    checkout: bridge/install.sh makes a venv, installs the keryx-bridge
    command, creates ~/.config/keryx/bridge.env with a fresh board token and
    the systemd user service. keryx-bridge runs the bridge, checks the
    settings against Hermes and xAI, pairs a board on USB (Wi-Fi, this
    machine's address, the token) and shows status or sets the volume
    through the bridge's HTTP control, which also feeds the board's volume
    into the prompt's device status section.
    The bridge now sends text.done after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
2026-10-04 📦 Release images and a flash script that needs no ESP-IDF
    firmware/release.sh builds firmware/keryx from a committed tree into
    firmware/release/: the parts with their addresses (not a merged image,
    which would wipe the pairing in NVS), VERSION and an ESP Web Tools
    manifest. firmware/flash_release.py flashes them with just esptool: it
    finds the board by USB ID, sends `bootloader` to Keryx firmware and
    checks that the board comes back with the new version.
    `status` now tells whether the XVF3800 answers, its firmware version
    and whether it clocks I2S (only its I2S firmware does); README says how
    to put it on that firmware. The version ignores firmware/release/.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
2026-10-04 📦 Release 0d29ff5
2026-10-04 ✨ Set up Keryx with one script
    setup.sh, run on the machine that will host the bridge with the board on
    USB, installs the bridge and its service (asking for the xAI and Hermes
    keys when the config lacks them), flashes the release with
    firmware/flash_release.py and pairs the board. --no-flash, --no-service
    and --port cover the other cases; bridge/README.md now starts with it and
    also explains pairing from another computer.
2026-10-04 💬 Tell Hermes where the bridge lives
    The device status lines appended to the voice prompt now also say where
    the bridge's checkout and config are, how its service is run and logged,
    and the keryx-bridge command for the volume, so Hermes on the same
    machine can change the volume or look into the bridge's code when asked.
2026-10-04 🔊 Add set_volume.sh for Hermes to call
    ./set_volume.sh 60, +10 or -10 sets the board's volume through the bridge
    running on this machine and prints the volume the board reports; with
    no argument it prints the current one. The device status lines now point
    Hermes at it instead of the keryx-bridge command.
2026-10-04 📝 Point the bridge at docs/flashing.md and drop a real board id
    The protocol example used the id of an actual board, part of its MAC;
    it is a made-up one now. Links and the XVF3800 hint in `pair` go to the
    new docs/flashing.md.
2026-10-04 🗣️ Let Hermes speak on its own with say.sh
    ./say.sh "text" (or keryx-bridge say, or POST /keryx/say) synthesizes the
    text with xAI on a socket of its own and plays it on the board once any
    answer in progress is over, returning when the board has played it. In a
    conversation the words also feed the echo filter, and the text goes into
    the voice history. The device status lines point Hermes at say.sh, for
    reminders, timers and anything the user asked to be told later.
2026-10-04 ⚡️ Keep Wi-Fi awake while the bridge plays on its own
    The bridge can now speak first (Hermes' say), with no wake before it.
    Power save went off only at a wake, so such an answer came over modem
    sleep. It now also goes off while an answer plays, and back on 5 s
    after.
2026-10-04 📦 Release 61072ba
2026-10-04 🐛 Stop Keryx from interrupting itself on its misheard echo
    With the board's speaker, speech-to-text keeps hearing Keryx and mishears
    its words (узнаю as знаю, имя as имени), which the echo filter's
    five-letter match missed: the answer stopped as if the user had spoken,
    and the fragment went to Hermes as a request. Words now count as echo
    when they are close to any word Keryx said, and words of one or two
    letters during playback do not count for the user. An answer stops only
    for at least two of the user's words, no fewer than the echo's, or a
    stop word; a final utterance of up to three words drowned in twice as
    much echo is dropped.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
    [voice.py]
2026-10-04 📝 Describe Keryx in the README, with a photo of the prototype
    The README now says what Keryx does and how (wake word on the board, the
    bridge, Hermes, xAI speech), what it needs, the one-command setup and
    where the documentation starts (docs/index.md). The photo's Seeed label
    with its QR code and serial number is pixelated.
2026-10-04 📝 Link the XIAO ESP32S3 and the reSpeaker Flex in the README
2026-10-04 🔇 Mute the microphone from the bridge
    ./mute.sh [30m] and ./unmute.sh (keryx-bridge mute|unmute, POST
    /keryx/mute) send the new protocol message {"type":"mute","value":…};
    the board, not the bridge, stops waking and streaming, and keeps the
    state across restarts (firmware side to follow). A timed mute is the
    bridge's timer. The board's state comes with hello and every change,
    shows in keryx-bridge status and in the device status lines, so Hermes
    can mute when asked not to listen; muting ends a conversation in
    progress. Only the microphone: the board still speaks.
2026-10-04 🔇 Mute the microphone on request
    While muted nothing captured leaves the board: the USB microphone and
    the bridge get silence, a running stream stops at once and the wake
    word does not run; playback goes on. The state is kept in NVS (read
    before capture starts), marked by a falling or rising two-note sound,
    set with `mute on|off` on the console and {"type":"mute"} from the
    bridge, and reported back after every change and in hello.
2026-10-04 📦 Release a71fb59
2026-10-04 📄 License Keryx under Apache 2.0
    The README lists the vendored components' own licenses and where the
    board images come from; the bridge package declares the license too.
2026-10-04 📝 Show the architecture as a picture in the README
2026-10-04 📝 Drop the image credit line from the README license section
2026-10-04 ✨ Keep the voice conversation in a Hermes session
    Each request carries only the new utterance with X-Hermes-Session-Id and
    X-Hermes-Session-Key: keryx; Hermes keeps the history. A wake word within
    KERYX_SESSION_TIMEOUT (1h) of the last exchange continues the session, which
    survives restarts. Interruptions and say.sh reach Hermes as bracketed notes.
    KERYX_FOLLOW_UP sets the follow-up window, now 7 s.
2026-10-04 🐛 Close the board's playback when an answer fails
    When Hermes or TTS raised mid-answer, the error path only cancelled the
    receiver: the board got neither play_stop nor play_end, so it kept its
    playback open (Wi-Fi awake, say.sh waiting on it), and audio still being
    synthesized on the shared TTS socket could leak into the next answer. The
    error path now shares the interruption's cleanup (Assistant.abandon):
    speaker.clear() and a fresh TTS socket.
    Checked with a mocked Hermes failing after the first sentence: before,
    speaker.clear() 0 calls and the TTS socket left open; after, 1 call, the
    socket closed and reopened.
    [voice.py]
2026-10-04 🐛 Decide the Hermes session at the wake word, not per request
    The session timeout was checked before every request, so with a timeout
    shorter than a conversation (0 in particular, documented as a new session
    per wake word) every follow-up went to a fresh session and Hermes lost the
    exchange just before it. The bridge now decides when a conversation begins
    (and in say.sh when none is running) and keeps that session for all its
    exchanges.
    Checked with a mocked Hermes, one wake word with two exchanges and then a
    second wake word: with --session-timeout 0, before 3 different sessions,
    after the same one twice and a new one for the second wake word; with 1h,
    one session throughout.
    Co-Author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
    [voice.py]
2026-10-04 🐛 Finish a timed mute that runs out while the board is away
    unmute_after cleared the timer and muted_until before sending the unmute,
    so when the board was disconnected at that moment set_mute returned None,
    nothing was left to retry, and the board came back still muted: a timed
    mute became a permanent one. A failed unmute now keeps muted_until, and
    when the board connects again resume_timed_mute lifts a mute that ran out
    meanwhile (or re-arms the timer for one still running).
    Checked with a stand-in board link offline when the mute ends and online
    afterwards: before, one failed unmute and the board stays muted; after,
    the unmute is sent again on reconnect and the board is unmuted.
    Co-A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
    [server.py]
2026-10-04 🐛 End the wake and sound console commands with ok
    `sound wake|thinking|stop` printed nothing and `wake` only its
    `wake score=…` event line, while every console answer is meant to end
    with an ok or error line: a client waiting for it, like keryx-bridge's
    board console (which skips `wake …` lines as events), sat until its
    timeout although the command had worked. They now end with `ok …`.
    Checked that firmware/keryx builds (idf.py into a separate build
    directory); not flashed or run on the board.
    [main.c]
2026-10-04 📦 Release 8398e85
2026-10-04 🔊 Let Hermes use xAI's speech tags
    The voice prompt lists the tags xAI text-to-speech performs ([laugh],
    [pause], <whisper>…</whisper>, <singing>…</singing> and the rest) and when
    to use them. The bridge keeps them intact: speakable() no longer strips
    the > of a wrapping tag, an answer is not cut into TTS chunks inside a
    wrapping tag, and the echo filter and the notes to Hermes see the text
    without tags.
    Checked against xAI: the same phrase is 25% longer in <slow>, 16% shorter
    in <fast>, 4.4 dB quieter in <whisper>, 2 s longer with [long-pause];
    all 21 tags played on the board through say.sh.
    [server.py, voice.py]
2026-10-04 📝 Link xAI's list of voices
2026-10-06 ✨ Put our I2C peripherals on a bus of their own
    With the Adafruit rotary encoder (seesaw on a SAMD09) on the XVF3800's bus, the XVF3800 holds SCL for up to half
    a second after its address and stops answering, so the ASR gain is never set. The STEMMA QT peripherals now get
    I2C_NUM_1 on D0/D3. Console: `i2c scan` lists both buses, `i2c read|write` talk to the peripherals' one.
2026-10-06 ✨ Add the knob and LED ring panel, a clock, and the console over Wi-Fi
    - keryx_panel: the Adafruit seesaw rotary encoder (volume, a short press to stop or wake, a long one to mute) and
    the NeoDriver ring of 24 WS2812 showing listening / thinking / speaking / muted, the volume after a change, and a
    clock when idle (amber marks, blue minute hand, two green pixels for the hour; red marks when muted). Modules may
    be missing or plugged in later.
    - ring top|reverse and ring brightness day|night <1-100> [HH:MM] on the console, kept in NVS; time over SNTP.
    - Protocol v1 gains {"type":"stop"} (the stop button ends the conversation) and {"type":"console"}: the bridge's
    POST /keryx/console, k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
    [cli.py, keryx_panel.c, keryx_panel.h, main.c]
2026-10-06 📦 Release 60b381d
2026-10-06 ✨ Update the firmware over Wi-Fi, from GitHub releases or any URL
    - keryx_ota: `ota`, `ota check`, `ota update [force]` (the latest GitHub release) and `ota url <url>`, on the console
    and over Wi-Fi; the download writes the other app slot and restarts into it, the ring shows the progress.
    - The bootloader rolls back a new image that restarts within 30 s (CONFIG_BOOTLOADER_APP_ROLLBACK_ENABLE); after
    that the app keeps itself. A board needs one USB flash with this bootloader.
    - firmware/publish.sh makes firmware/release/ the latest GitHub release; tools/ota_push.py flashes a local build
    over Wi-Fi through the bridge's console or USB.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
2026-10-06 📦 Release 17c2b76
2026-10-06 🐛 Fit GitHub's signed redirect into the OTA request buffer
    `ota check` failed with ESP_ERR_HTTP_WRITE_DATA once a release existed: the request to the release asset's signed
    URL did not fit into 1 KB.
2026-10-06 📦 Release a0d4b91
2026-10-06 🔧 Add watch_board.sh: USB, ping and bridge, once a second
2026-10-06 💄 Clock marks amber by day, yellow at night
    By day the yellow marks looked green: amber (R 12 G 6 at 10 %). At a night's 2 % the eye takes R 2 G 1 for red, the
    same as the marks of mute: yellow there (R 2 G 2).
2026-10-06 📦 Release 975d330
2026-10-06 🥅 Show how the last update went in `ota`
    An update's lines went to the serial port only, so over Wi-Fi a failed `ota update` left no trace; `ota` now shows
    the last result.
2026-10-06 ✨ Let say speak at a volume of its own, for Hermes at night
    say.sh --volume N, keryx-bridge say --volume N and POST /keryx/say {"volume": N}: below the board's volume the
    bridge turns the speech down itself, so the board's volume and ring stay as they are; above it the board's volume
    goes up for the phrase and back. Hermes is told to use a low one at night or when asked to be quiet.
2026-10-06 ✨ Let say take a volume relative to the board's
    say.sh --volume -20 / +10 and POST /keryx/say {"volume_delta": n}, as set_volume.sh takes +n / -n.
2026-10-06 📦 Release 6586909
2026-10-06 📝 Add the assembly in an Edifier R1100, with photos
2026-10-06 📝 Draw the wiring of the R1100 build
    Power from the speaker's 17 V through two step-downs (12 V for the Flex, 5 V for the ring), the STEMMA QT bus from
    the Flex's pins through the encoder to the NeoDriver, and SPEAKER through the isolation transformer into AUX R.
2026-10-06 📝 Show the R1100 build in the README, front and back
2026-10-10 ✨ Choose what speech-to-text hears: processed, ASR or auto
    Inside the speaker the ASR beam (R) carries Keryx's own voice at about the user's level, and STT took it for the
    user: the answers interrupted themselves. `stt channel l|r|a` (NVS, also over Wi-Fi): l, the default, sends the
    processed beam, where the XVF3800's residual echo suppression removes it; r the ASR beam as before; a crossfades
    (30 ms) to L while the board plays and back to R a second after. L is brought to R's level by ASR gain / AGC gain,
    read every 0.5 s. The wake word stays on R.
2026-10-10 🐛 Keep AEC_FAR_EXTGAIN at 0: our volume comes before the reference
    AEC_FAR_EXTGAIN is the gain between the AEC reference and the loudspeaker, as in the XVF3800's USB variant, which
    applies the host's volume there. Our volume is applied before the reference, so following it (401a6d1) told the
    residual echo suppression to expect 23 dB less echo at volume 54: measured on the board, Keryx's voice came through
    the processed beam at +20.6 dB over silence and Whisper read it word for word; at 0 dB it is +3.1 dB and nothing is
    heard. The firmware writes 0 at start-up, as the XVF3800 keeps it across a restart of the ESP32 alone.
2026-10-10 🔊 Turn on the XVF3800's non-linear echo attenuation at start-up
    PP_NLATTENONOFF, the last stage of the processed beam's echo suppression, is off in Seeed's firmware. In the R1100,
    with the user silent while Keryx counted: Keryx's voice in L at +6.1 dB over the room's noise without it, below the
    noise with it, at volume 54 and at 80, the first second included; the user reading a sentence over Keryx came
    through Whisper word for word either way. Written at start-up with AEC_FAR_EXTGAIN, as the XVF3800 forgets it at
    power-off; `status` shows `nl_atten`.
    [main.c, xvf_control.h]
2026-10-10 📦 Release 3dbc389
2026-10-10 🐛 Use software AES, so updates from GitHub fit into internal RAM
    `ota check` and `ota update` failed with "esp-aes: Failed to allocate memory": the hardware AES goes through DMA,
    which reads internal RAM only, and for TLS buffers in PSRAM it asks for a bounce buffer there, which the update
    task's 8 KB stack had left no room for. The software one works in PSRAM; TLS is only used for updates.
2026-10-10 📦 Release 24824f1
2026-10-10 🔊 Make the volume the codec's analog volume, so the DAC's hiss goes down with it
    The DAC hisses: with the volume a software gain before it, the hiss stayed as loud at any volume. The volume now sets
    the TLV320AIC3104's analog volume in front of its output drivers (0.5 dB a step, soft-stepped; listened to, the hiss
    follows it): registers 47/64 for the jack at 100 - v steps, 82/85 for the line output to the amplifier 12 steps lower,
    as it mixes both DACs; 0 also mutes the routes and the drivers. The drivers' levels stay as the XVF3800 set them
    (raising the line's only raised the hiss). The XVF3800 sets the codec up at boot, so the registers are read back every
    2 s and set again. As the volu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
2026-10-10 📦 Release 501c502
2026-10-10 🐛 Give the console a 6 KB stack: `status` overflowed 4 KB
    With the codec's line added, `status` overflowed the console task's 4 KB stack and the board restarted (reliably over
    Wi-Fi about a minute after boot, every time once a 320-byte buffer was added to it). The console's stack stays in
    internal RAM, as commands write NVS. `status` now shows the codec registers as the xvf task last read them, so only
    that task talks to the codec.
2026-10-10 📦 Release e48fe65
2026-10-10 ✨ Add the printed parts: mic hat and encoder knob as Onshape features
    Each part is a parametric Onshape custom feature written in FeatureScript (cad/*.fs) with the STL it was printed
    from. The mic hat covers the microphone array with slots over each mic, a post for double-sided tape and an
    engraved label; the encoder knob has a nut skirt, one support-free cone to a bore with crush ribs. The bottle cap is
    the test piece the workflow started with. STL, 3MF and STEP go through Git LFS; .mcp.json connects Onshape's
    FeatureScript MCP server; cad/README.md describes the parts and how to edit them.
    [bottle_cap.stl, encoder_knob.stl, mic_hat.stl]
2026-10-11 🖼️ Add the herald title image as a docs asset (#1)
    Key art of Keryx the herald proclaiming from the temple steps, with the speaker grille set into the marble. Unreferenced on purpose: an asset for the project catalogue and other presentation surfaces, not part of any document here.
2026-10-11 🔍 Capture diagnostics for voice interruptions
2026-10-11 📸 Show the printed mic hat: assembly photos and a new front photo in the README
2026-10-11 🔊 Keep the echo path fixed: play on R, put the volume on the AEC reference in L
    With the volume on the codec after the AEC reference, turning it down broke echo cancellation: the AEC follows a
    louder echo but never a quieter one, so after the volume went down Keryx's own voice stayed in the ASR beam at about
    -35 dBFS, at any lower volume and even with the speaker muted, until the XVF3800 restarted. AEC_FAR_EXTGAIN (set to
    the volume or its opposite), path change detection and rescaling the AEC filter by hand did not help.
    The XVF3800 takes its reference from I2S channel L only and sends both channels to the DACs. The playback task now
    puts the mono mix at full scale in R, routed at the c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
2026-10-11 ✨ Show listening and speaking as level meters from 3 and 9 o'clock
    The whole ring used to light as one: blue breathing while listening, deaf to the voice, and green pulsing with the
    answer. Now both draw a meter: the pixels at 3 and 9 o'clock stay at half brightness, and arcs grow from them both
    ways to meet at 12 and 6 at full level, brightest at their roots, quick up and slow down, over a faint glow.
    Listening follows the ASR beam's peak (-45 to -12 dBFS), answering what is played before the volume (-40 to -8 dBFS:
    the answers, the board's sounds and USB audio alike). The colours move apart a little, around blue: 220 for listening,
    160 for speaking, set with `ring hue` and kept in NVS.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
2026-10-11 📦 Release 3a6ee0c
2026-10-11 🎥 Add a demo video and link it from the README
2026-10-11 🎥 Play the demo video inline in the README
2026-10-11 🖼️ Put the front, back and demo video side by side in the README
2026-10-11 📝 Link the assembly page under the README's photos
2026-10-11 📝 Shorten the README's photo captions to Front, Back and Demo
2026-10-18 ✨ Tag every request with who is talking: voice ID
    The bridge now tells Hermes who is speaking: each request goes with a tag in
    front, [voice: Name 0.97], the most likely of the household's speakers (or
    unknown, or two names for two people in one utterance) and how sure that is.
    keryx_bridge/voiceid.py takes the audio of an utterance's non-echo words from
    the board's stream, embeds it with ERes2NetV2 and CAM++ (sherpa-onnx, the new
    voiceid extra), scores it against the voice profiles and calibrates it; the
    belief carries over a conversation with a stay probability that falls with the
    pause. It runs in a thread and the request waits for it at most 2 s.
    voiceid/ makes the bundle the bridge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
2026-10-18 ⚡️ Embed the slow model on an utterance's first 2 s, the models side by side
    On the Raspberry Pi 5 ERes2NetV2 takes about 0.23 s per second of audio, so a
    6 s request waited 2 s for its voice tag before it went to Hermes. Now
    ERes2NetV2 hears only the first 2 s of an utterance (the bundle's crops, and
    calibrate.py --crop trains it the same way), the two models run in threads of
    their own and the two-speaker check uses windows that do not overlap: 0.5 s
    for a 2 s utterance, 0.8 s for 6 s. On the recordings the cropped model does
    as well as the whole one; CAM++ alone lets twice as many impostors through.
    Claude-Session: https://claud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
2026-10-18 🔊 Keep every utterance voice ID hears, to calibrate it on real days
    The profiles and the calibration come from one evening of recordings; what
    they lack is other days, colds and real guests. The bridge now keeps every
    utterance voice ID heard: per day a folder in ~/.local/share/keryx/voiceid/log
    with the 16 kHz WAV it embedded and a voices.jsonl line with the tag, the
    probabilities, the cosines, the pause and the transcript. It is written in
    the voice ID thread, so requests do not wait for it, and days older than 90
    (KERYX_VOICEID_LOG_DAYS) are deleted; --no-voiceid-log turns it off.
    Claude-Session: https://claude.ai/code/session_01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
2026-10-18 🐛 Keep the LED ring moving while an answer's audio streams in
    As Keryx began to speak, the ring stood still for a second or two on the last
    frame of the thinking comet. The bridge sends an answer's audio faster than
    real time, about 10 s of it in a second, and while it came in Wi-Fi, lwIP and
    the WebSocket client kept core 0 busy above the panel's priority 3: measured,
    no frame for 213, 859 and 290 ms in a row. The panel now runs on core 1, under
    capture and playback, which leave three quarters of it free; the same answer
    now shows no late frame.
    status counts the frames that come 150 ms or more late (stalls=… longest=…),
    and the log names each with the panel's state. The panel's sta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
2026-10-18 📦 Release e1c89d9
    Claude-Session: https://claude.ai/code/session_01LFu8KGv56kywze8pxjPrNJ
2026-10-18 🔇 Do not count the panel's late frames while an update writes flash
    Writing flash stops the caches, and with them the panel's task, every few
    hundred ms: an OTA update logged a hundred "no frame for 250 ms" warnings,
    which are expected there and hide real stalls in the count.
    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
2026-10-18 📦 Release 242fafb
    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
2026-10-25 🐛 Keep a journal through a lost bridge, and get the board back by itself
    The board once stayed off Wi-Fi for eight hours, until it was powered off, which left nothing to say why. Now every
    console line but the 5 s report goes into a journal in PSRAM; a watchdog saves its end in NVS after 3 min without the
    bridge and restarts Wi-Fi, after 10 min restarts the board (then every hour). The hello says "saved_log":true, and the
    bridge reads it into its own log and clears it. A Wi-Fi connect that fails at once is now retried: it sends no
    disconnect event, so the retries used to stop there.
2026-10-25 📦 Release d12e52d
